iRobotics-Pacbot-2022-2023/Electrical/(commit log)

2022-12-03 Top Board
    Created Top Board KiCad project. Subject to renaming when boards are better understood.
    [Top Board.kicad_pcb, Top Board.kicad_sch]
2022-12-10 Top Board Management
    Leftover changes from creating top board? Pushing for now but will look into them
2022-12-10 Testing Symbol Library Creation
    Pushing a test symbol in order to test how symbol libraries work between kicad and github
2022-12-10 add new test symbol in symbol folders
    [Top Board.kicad_sch]
2023-01-21 DRV8876 KiCad Schematic Complete
2023-01-21 VL53L4CX TOF added
    Adafruit VL53L4CX TOF sensor added to symbol library
2023-01-21 Revert "Merge branch 'motor_controller_branch'"
    This reverts commit 0f5a80eb67d65929ca78b85239dc9413235aba2e, reversing
    changes made to cc46030deb95eece420e09bd20f8e198b64c1a43.
2023-01-21 added imu symbol
2023-01-28 adding imu symbol
2023-01-28 Created Board1
    [board1.kicad_pcb, board1.kicad_sch]
2023-01-28 Created Board1 Libs
2023-01-28 modified imu symbol
2023-01-28 Created D24V50F5(5V regulator)
2023-02-04 added raspberry pi zero W symbol
2023-02-04 added raspberry pi and teensy symbols
2023-02-11 Motor driver symbol done
    DRV8876 Single Brushed DC Motor Driver Carrier
2023-02-11 Updated TOF sensor
2023-02-25 Updated Schematic
    Created zones for each individual part in the schematic and we decided on using hierarchal labels
    [board1.kicad_pcb, board1.kicad_sch]
2023-03-03 Created Physical Board Layout
    Created Edge Cuts for Physical Board
    Layout based off of Rushil's drawing
    [board1.kicad_pcb]
2023-03-03 Updated Edge Cuts
    Updated edge cuts with updated dimensions
    [board1.kicad_pcb]
2023-03-04 Connected RPI to Teensy SPI
    [board1.kicad_sch]
2023-03-04 created footprint library and motor controller pinheader
2023-03-04 Added SDA and SCL to IMU
    [board1.kicad_sch]
2023-03-04 modified motor controller footprint and created IMU footprint
2023-03-04 created teensy footprint
2023-03-04 created rasp pi footprint
2023-03-07 pcb layed out, need help with ratsnest
2023-03-09 Updated Footprints
    Updated Footprints to indicate physical limitations of components
    [board1.kicad_pcb, board1.kicad_sch]
2023-03-09 updated board pcb to better match physical constraints
    [board1.kicad_pcb]
2023-03-09 slight edits
    [board1.kicad_pcb]
2023-03-10 made changes
    [board1.kicad_pcb, board1.kicad_sch]
2023-03-14 preliminary routing of traces
    [board1.kicad_pcb, board1.kicad_sch]
2023-03-15 Routed PCB
    routed pcb
    [board1.kicad_pcb]
2023-03-16 Updated PCB
    Flipped Encoder, Increased Trace Size, and Changed Resistors to be 0805
    [board1.kicad_pcb, board1.kicad_sch]
2023-03-17 added ground layer and is now 4 layer pcb
    [board1.kicad_pcb]
2023-03-17 additional changes
    [board1.kicad_pcb]
2023-03-19 updated board to be 90x90, new board can be found in the folder "90x90"
    [Top Board.kicad_pcb, Top Board.kicad_sch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]
